TechTronics2024/WRO-Future-Engineers-2024/Vehicle Pictures/Bottom.jpg

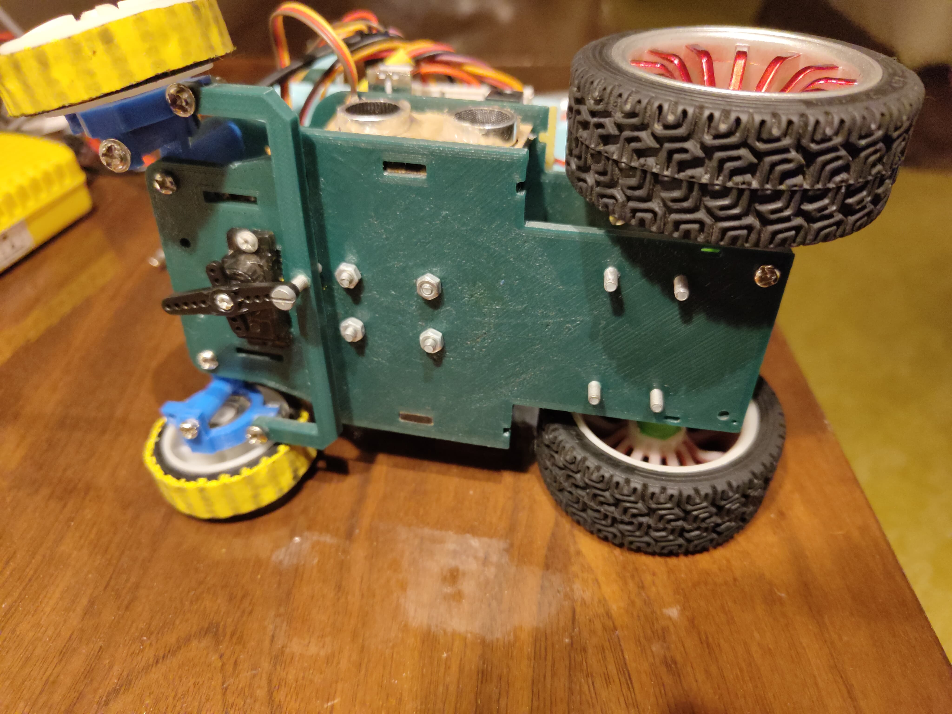
Vehicle Pictures/Bottom.jpg
