TechTronics2024/WRO-Future-Engineers-2024/Vehicle Pictures/Back.jpg

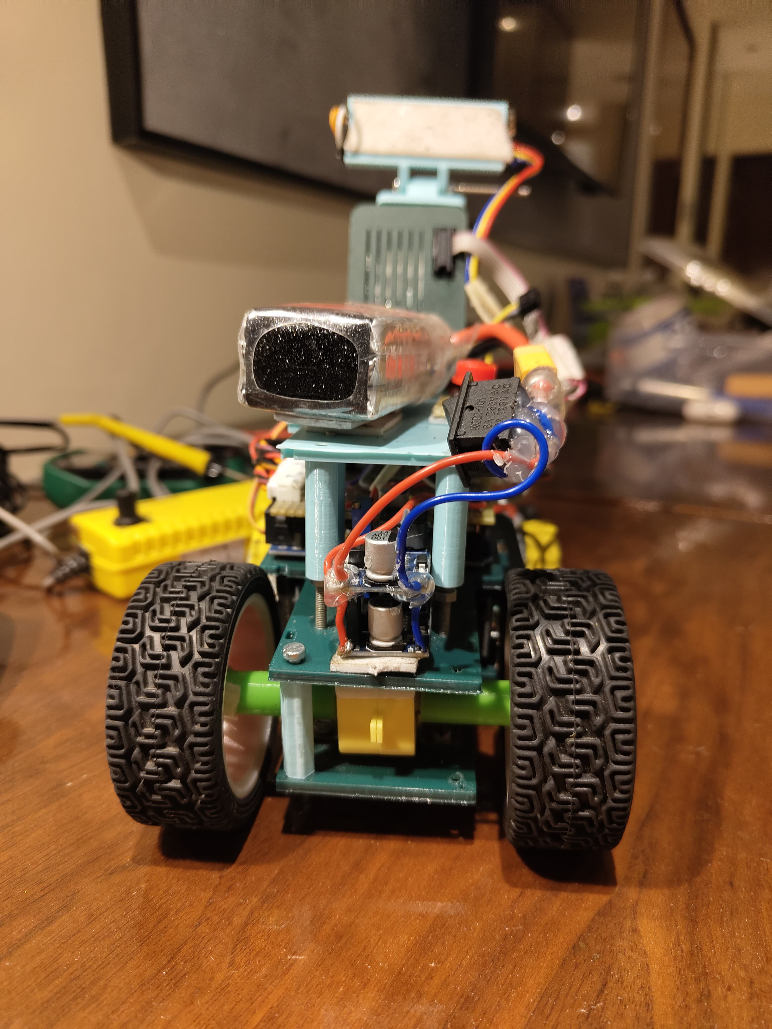
Vehicle Pictures/Back.jpg
