TechTronics2024/WRO-Future-Engineers-2024/Cad/README.md

Cad and Mobility Management
===
includes the final bot cad in .step format which was made using fusion 365 along with a pdf explaining all the iterrations used in making the bot.
