TechTronics2024/WRO-Future-Engineers-2024/Codes/README.md

Robot Control Codes
===
All programs uploaded to bot components which are used to complete the chalange
## Test Codes
Codes which can be used to debug mechanical errors by checking the sensor inputs and motor outputs

## Round 1 Codes
Includes all codes uploaded during round 1 including ones with diffrent speeds and round 1 flow chart

## Round 2 Codes
Includes all codes uploaded during round 2 and round 2 flow chart

## Pixy Parameter Files
Files used to configure the pixy camera in the format .prm format
