TechTronics2024/WRO-Future-Engineers-2024/Codes/Round 1 Codes/Flowchart.pdf

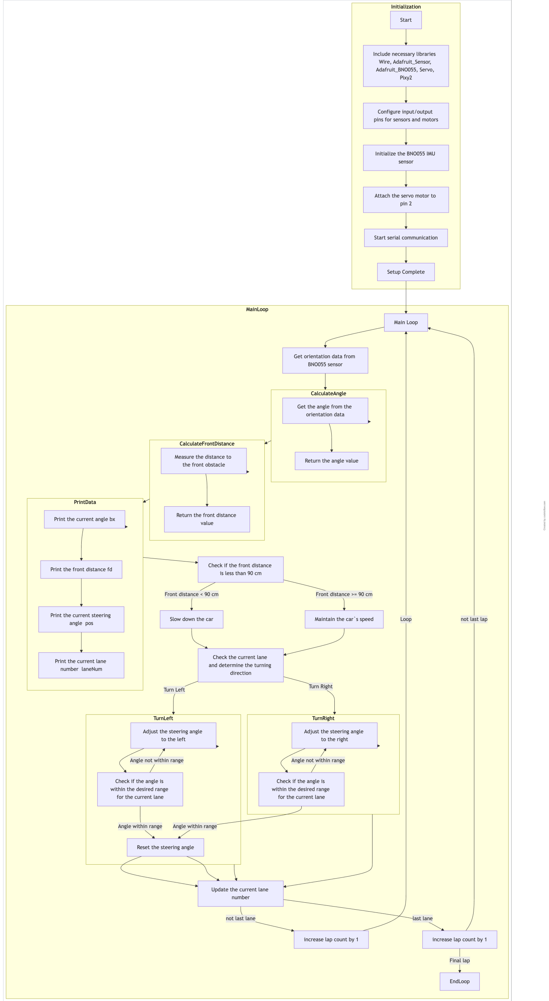
[picture p3: page 1]
