TechTronics2024/WRO-Future-Engineers-2024/Codes/Round 2 Codes/Flowchart.pdf

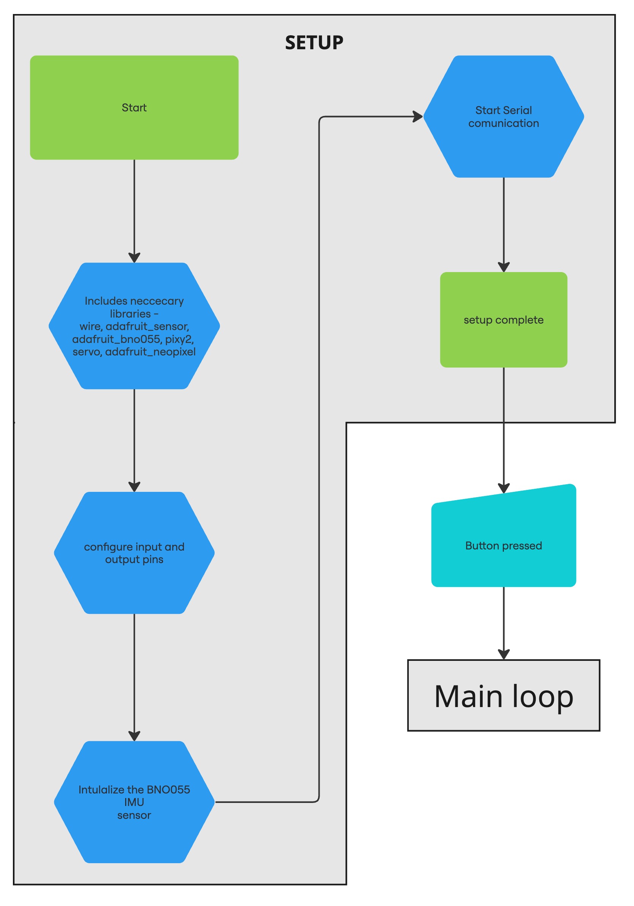
[picture p4: page 1]
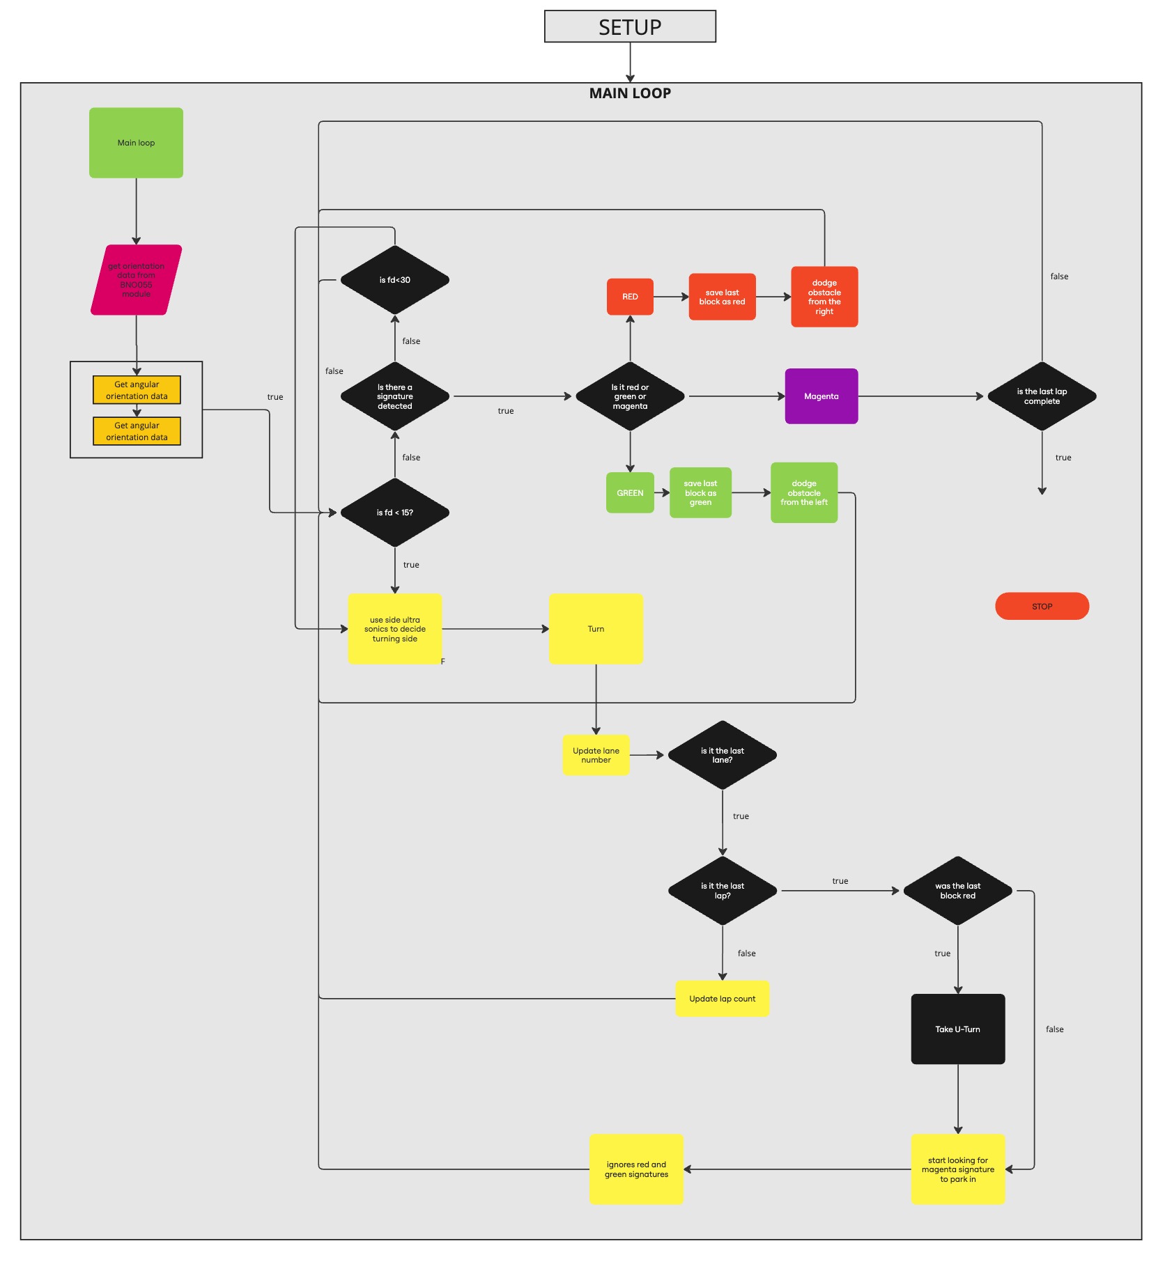
[picture p5: page 2]
