TechTronics2024/WRO-Future-Engineers-2024/Team Pictures/Team Image.jpg

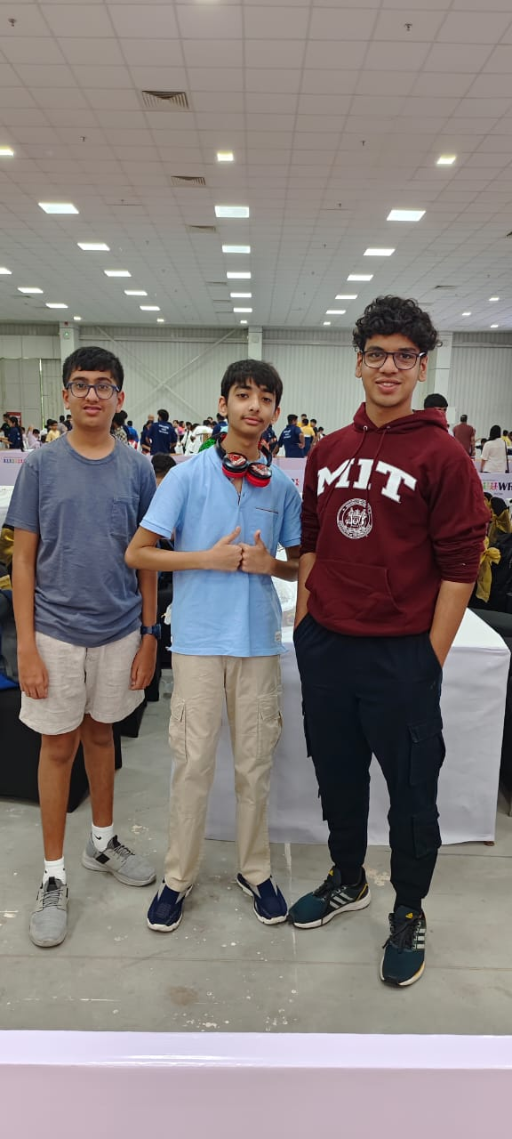
Team Pictures/Team Image.jpg
