TechTronics2024/WRO-Future-Engineers-2024/Vehicle Pictures/Front.jpg

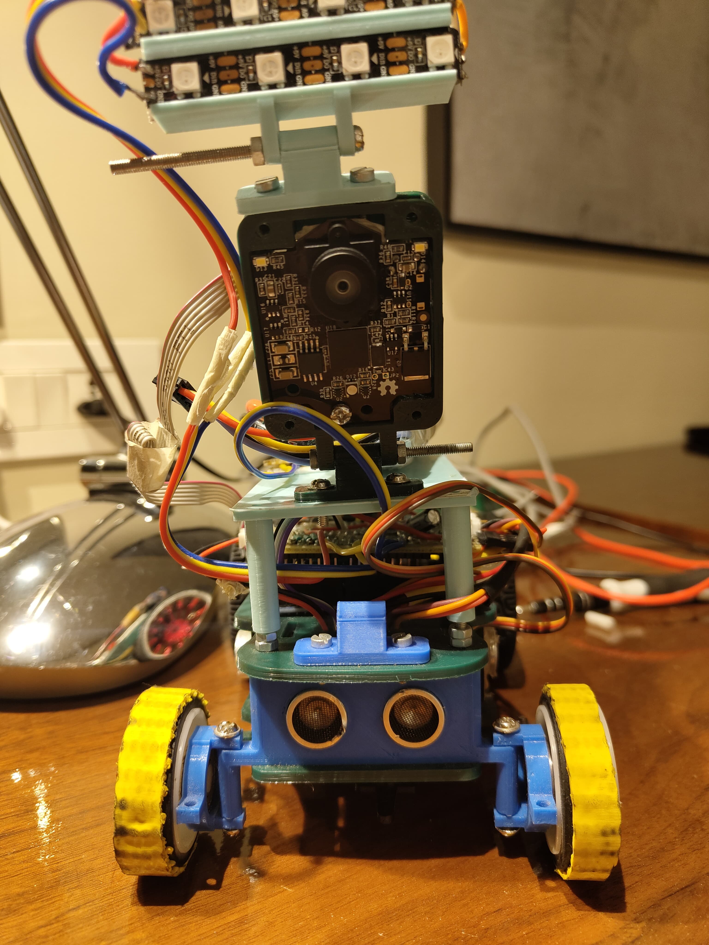
Vehicle Pictures/Front.jpg
