TechTronics2024/WRO-Future-Engineers-2024/Vehicle Pictures/Left.jpg

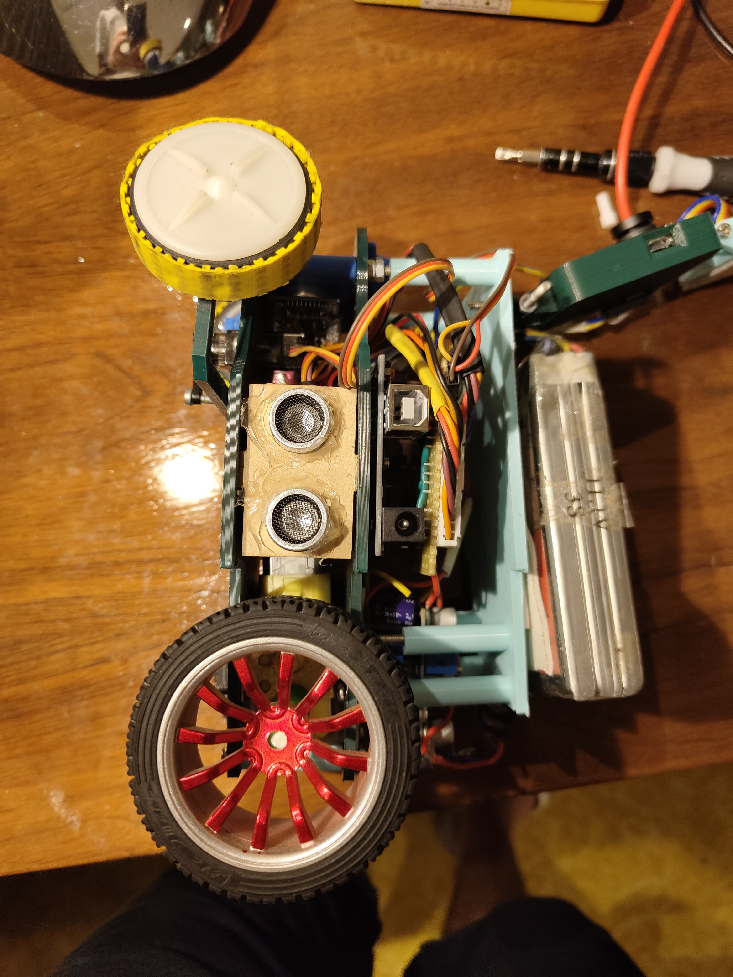
Vehicle Pictures/Left.jpg
