TechTronics2024/WRO-Future-Engineers-2024/Vehicle Pictures/Right.jpg

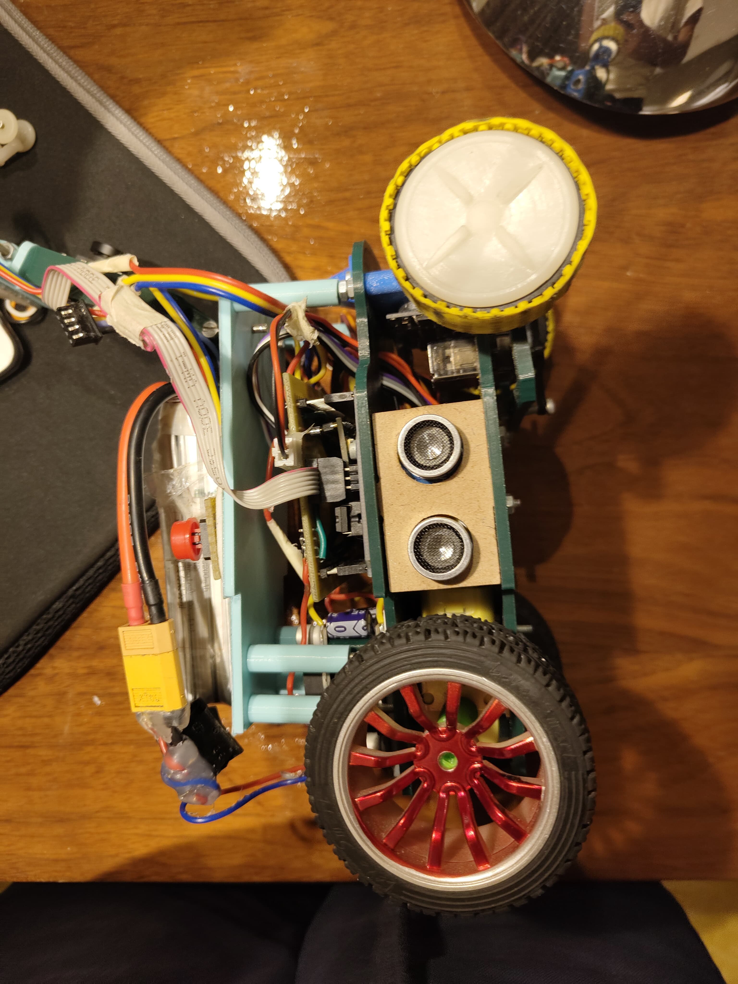
Vehicle Pictures/Right.jpg
