TechTronics2024/WRO-Future-Engineers-2024/Vehicle Pictures/Top.jpg

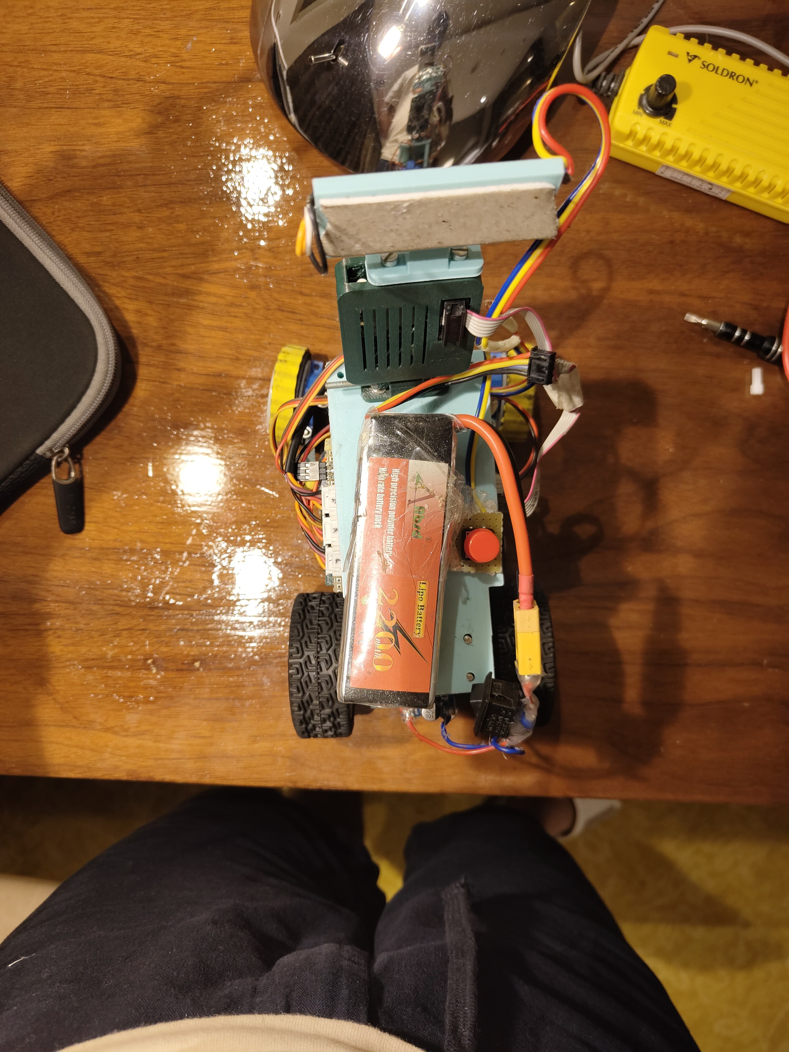
Vehicle Pictures/Top.jpg
