TechTronics2024/WRO-Future-Engineers-2024/Electronics/bill_of_material.md

Bill Of Material
===
* LM2596, buck converter, 5V & 6V
* Ultrasonic sensors (x3)
* Motor driver, 1A, dual, TB6612FNG
* Pixycam
* BO motor, 12v, 300rpm
* BNO055
* Arduino UNO
* Push button
* Switch
* Neo pixel (x8)
* MG90 Mini servo
* 11.1, 3 cell, 2.2A liPo Battery
