TechTronics2024/WRO-Future-Engineers-2024/Electronics/Circuit Diagram.pdf

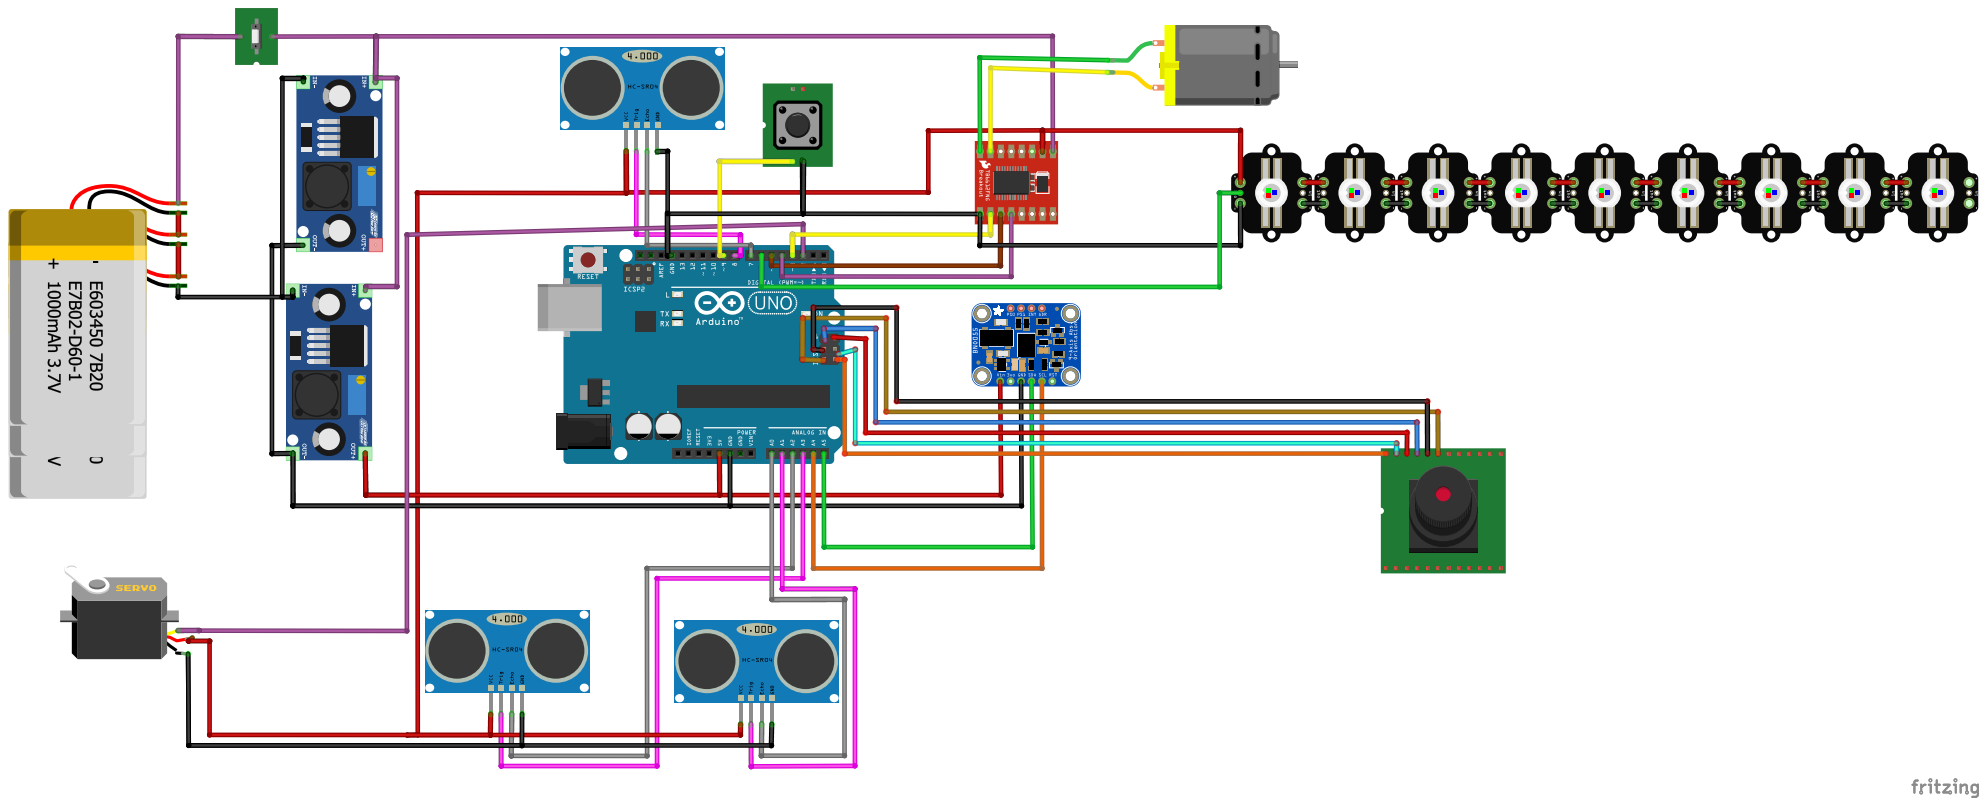
[picture p11: page 1]
